bbokser/ponictron/hw/ponictron.kicad_pcb

## KiCad design hw/ponictron.kicad_pcb (2026-02-16)

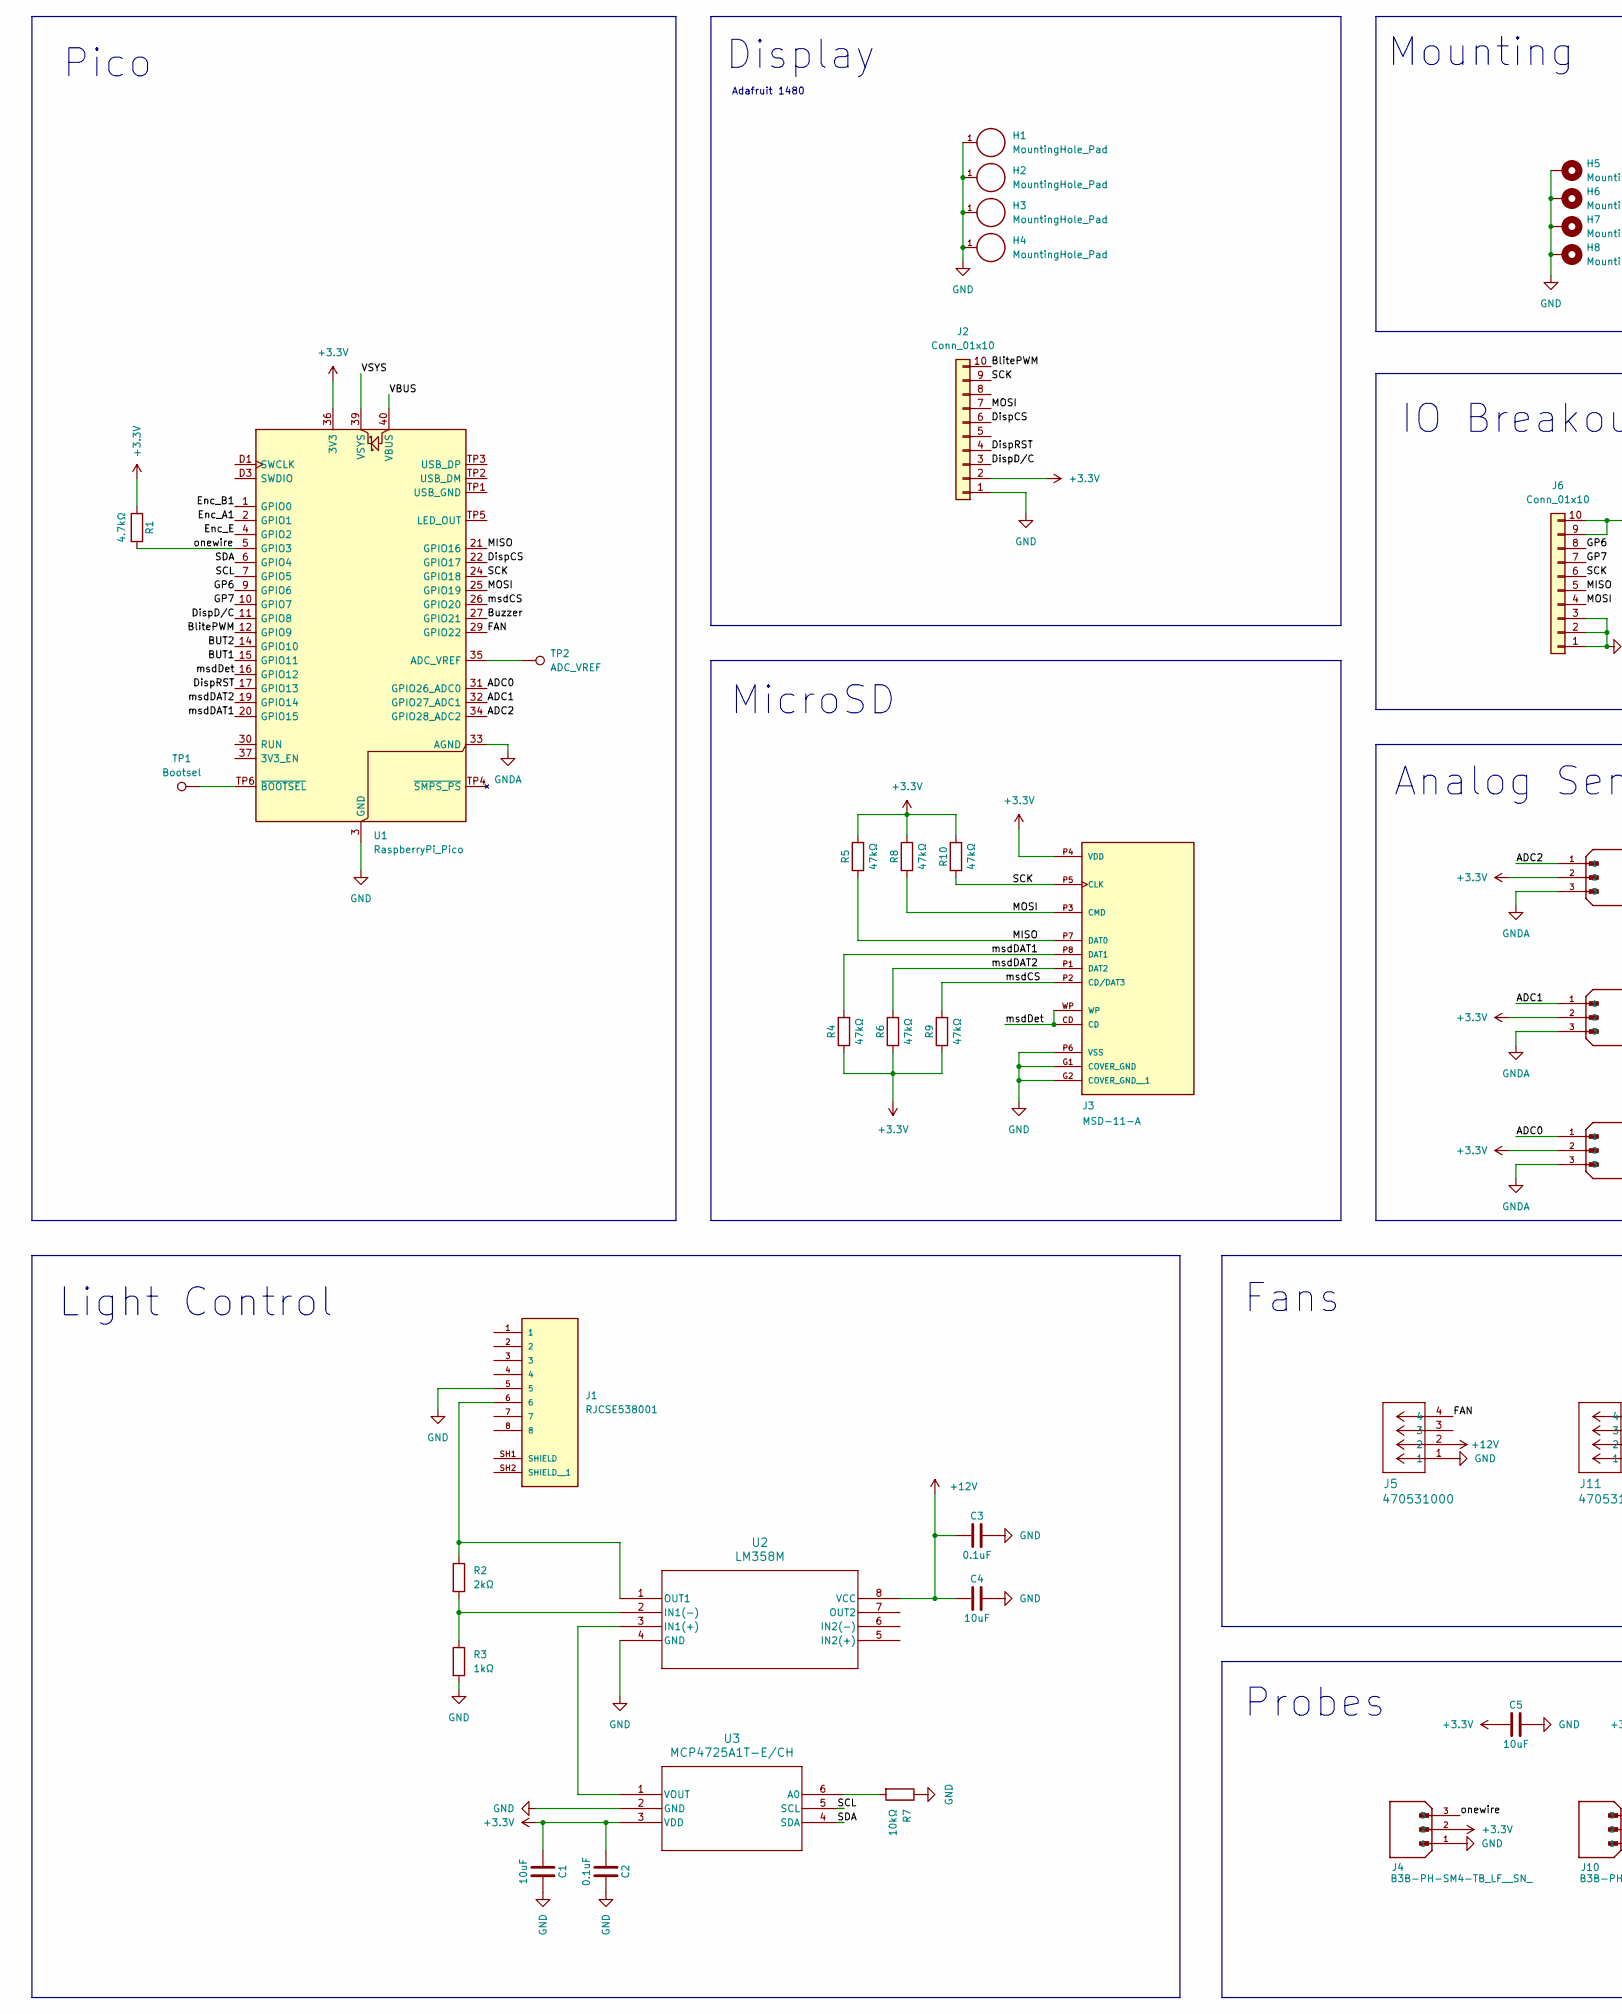
[picture p1: schematic ponictron.kicad_sch, part in row 1, column 1]

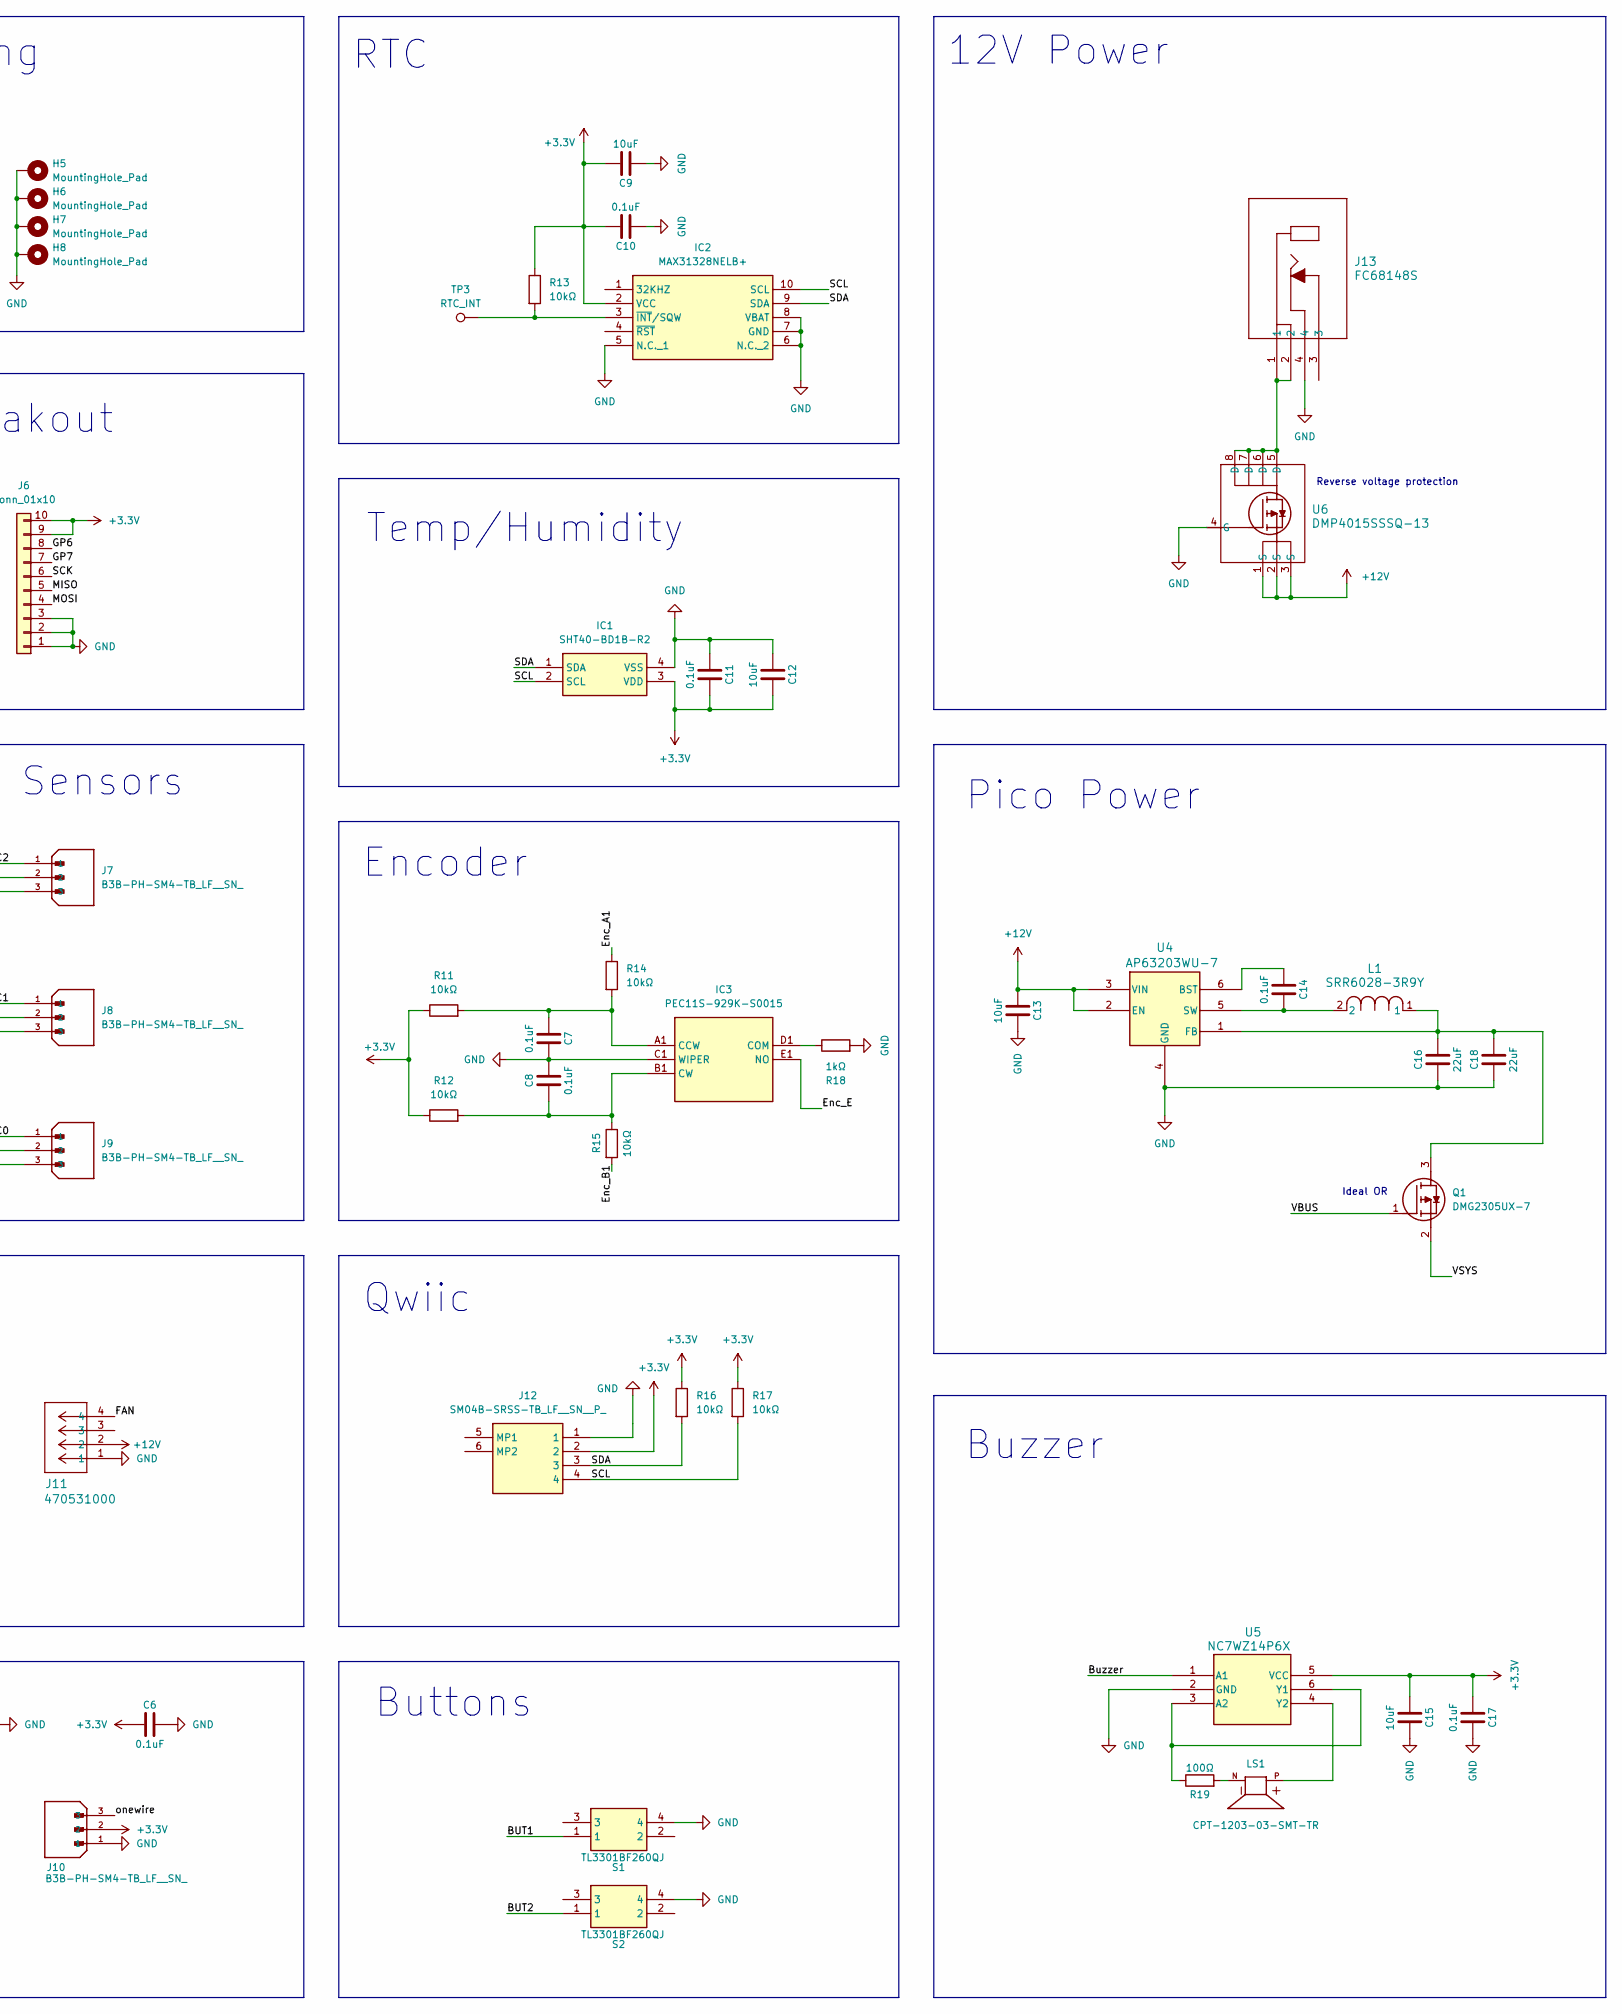
[picture p2: schematic ponictron.kicad_sch, part in row 1, column 2]

Parts:
C1, C4, C5, C9, C12, C13, C15: 10uF; C_0603_1608Metric; LCSC Part # C105524
C2, C3, C6, C7, C8, C10, C11, C14, C17: 0.1uF; C_0603_1608Metric; LCSC Part # C105524
C16, C18: 22uF; C_0603_1608Metric; LCSC Part # C105524
H1, H2, H3, H4: MountingHole_Pad; WE-SMSA_78614015360
H5, H6, H7, H8: MountingHole_Pad; MountingHole_2.7mm_M2.5_DIN965_Pad
IC1: SHT40-BD1B-R2; SHT40BD1BR2; Mouser Part Number 403-SHT40-BD1B-R2
IC2: MAX31328NELB+; MAX31328NELB; Mouser Part Number 700-MAX31328NELB+
IC3: PEC11S-929K-S0015; PEC11S929KS0015; Mouser Part Number 652-PEC11S929K-S0015
J1: RJCSE538001; AMPHENOL_RJCSE538001; PARTREV A
J2, J6: Conn_01x10; PinSocket_1x10_P2.54mm_Vertical
J3: MSD-11-A; CUI_MSD-11-A; PARTREV 1.02
J4, J7, J8, J9, J10: B3B-PH-SM4-TB_LF__SN_; JST_B3B-PH-SM4-TB_LF__SN_; PARTREV N/A
J5, J11: 470531000; CONN_SD-47053-001_H10p00_MOL
J12: SM04B-SRSS-TB_LF__SN__P_; SM04BSRSSTBLFSNP; Mouser Part Number 306-SM04BSRSSTBLFSNP
J13: FC68148S; FC68148S_CLF
L1: SRR6028-3R9Y; IND_BOURNS_SRR6028
LS1: CPT-1203-03-SMT-TR; XDCR_CPT-1203-03-SMT-TR; PARTREV 1.0
Q1: DMG2305UX-7; SOT96P240X115-3N; Mouser Part Number 621-DMG2305UX-7
R1: 4.7kΩ; R_0603_1608Metric_Pad0.98x0.95mm_HandSolder; LCSC Part # C15401
R2: 2kΩ; R_0603_1608Metric_Pad0.98x0.95mm_HandSolder; LCSC Part # C15401
R3: 1kΩ; R_0603_1608Metric_Pad0.98x0.95mm_HandSolder; LCSC Part # C15401
R4, R5, R6, R8, R9, R10: 47kΩ; R_0603_1608Metric_Pad0.98x0.95mm_HandSolder; LCSC Part # C15401
R7, R11, R12, R13, R14, R15, R16, R17: 10kΩ; R_0603_1608Metric_Pad0.98x0.95mm_HandSolder; LCSC Part # C15401
R18: 1kΩ; R_0603_1608Metric_Pad0.98x0.95mm_HandSolder; LCSC Part # C103198
R19: 100Ω; R_0603_1608Metric_Pad0.98x0.95mm_HandSolder; LCSC Part # C15401
S1, S2: TL3301BF260QJ; Mouser Part Number 612-TL3301BF260QJ
TP1: Bootsel; TestPoint_Pad_1.5x1.5mm
TP2: ADC_VREF; TestPoint_Pad_1.5x1.5mm
TP3: RTC_INT; TestPoint_Pad_1.5x1.5mm
U1: RaspberryPi_Pico; RaspberryPi_Pico_Original_SMD
U2: LM358M; 8-SOP_OSI
U3: MCP4725A1T-E/CH; SOT-23-6_MC_MCH
U4: AP63203WU-7; AP63203WU-7_DIO
U5: NC7WZ14P6X; SC70-6_ONS
U6: DMP4015SSSQ-13; SO8_DIO

Connections:
+3.3V: C1.2, C2.2, C5.2, C6.2, C9.1, C10.1, C11.1, C12.1, C15.2, C17.2, IC1.3 (VDD), IC2.2 (VCC), J2.2, J3.P4 (VDD), J4.2, J6.9, J6.10, J7.2, J8.2, J9.2, J10.2, J12.2, R1.1, R4.1, R5.2, R6.1, R8.2, R9.1, R10.2, R11.1, R12.1, R13.1, R16.1, R17.1, U1.36 (3V3), U3.3 (VDD), U5.5 (VCC)
+12V: C3.2, C4.2, C13.2, J5.2, J11.2, U2.8 (VCC), U4.2 (EN), U4.3 (VIN), U6.1 (S), U6.2 (S), U6.3 (S)
/ADC0: J9.1, U1.31 (GPIO26_ADC0)
/ADC1: J8.1, U1.32 (GPIO27_ADC1)
/ADC2: J7.1, U1.34 (GPIO28_ADC2)
/BUT1: S1.1, U1.15 (GPIO11)
/BUT2: S2.1, U1.14 (GPIO10)
/BlitePWM: J2.10, U1.12 (GPIO9)
/Buzzer: U1.27 (GPIO21), U5.1 (A1)
/DispCS: J2.6, U1.22 (GPIO17)
/DispD/C: J2.3, U1.11 (GPIO8)
/DispRST: J2.4, U1.17 (GPIO13)
/Enc_A1: R14.1, U1.2 (GPIO1)
/Enc_B1: R15.2, U1.1 (GPIO0)
/Enc_E: IC3.E1 (NO), U1.4 (GPIO2)
/FAN: J5.4, J11.4, U1.29 (GPIO22)
/GP6: J6.8, U1.9 (GPIO6)
/GP7: J6.7, U1.10 (GPIO7)
/MISO: J3.P7 (DAT0), J6.5, R5.1, U1.21 (GPIO16)
/MOSI: J2.7, J3.P3 (CMD), J6.4, R8.1, U1.25 (GPIO19)
/SCK: J2.9, J3.P5 (CLK), J6.6, R10.1, U1.24 (GPIO18)
/SCL: IC1.2 (SCL), IC2.10 (SCL), J12.4, R17.2, U1.7 (GPIO5), U3.5 (SCL)
/SDA: IC1.1 (SDA), IC2.9 (SDA), J12.3, R16.2, U1.6 (GPIO4), U3.4 (SDA)
/VBUS: Q1.1 (G), U1.40 (VBUS)
/VSYS: Q1.2 (S), U1.39 (VSYS)
/msdCS: J3.P2 (CD/DAT3), R9.2, U1.26 (GPIO20)
/msdDAT1: J3.P8 (DAT1), R4.2, U1.20 (GPIO15)
/msdDAT2: J3.P1 (DAT2), R6.2, U1.19 (GPIO14)
/msdDet: J3.CD, J3.WP, U1.16 (GPIO12)
/onewire: J4.3, J10.3, R1.2, U1.5 (GPIO3)
GND: C1.1, C2.1, C3.1, C4.1, C5.1, C6.1, C7.1, C8.1, C9.2, C10.2, C11.2, C12.2, C13.1, C15.1, C16.2, C17.1, C18.2, H1.1, H2.1, H3.1, H4.1, H5.1, H6.1, H7.1, H8.1, IC1.4 (VSS), IC2.5 (N.C._1), IC2.6 (N.C._2), IC2.7 (GND), IC2.8 (VBAT), IC3.C1 (WIPER), J1.5, J2.1, J3.G1 (COVER_GND), J3.G2 (COVER_GND__1), J3.P6 (VSS), J4.1, J5.1, J6.1, J6.2, J6.3, J10.1, J11.1, J12.1, J13.4, R3.2, R7.1, R18.2, S1.4, S2.4, U1.3 (GND), U1.8 (GND), U1.13 (GND), U1.18 (GND), U1.23 (GND), U1.28 (GND), U1.38 (GND), U1.D2 (GND), U2.4 (GND), U3.2 (GND), U4.4 (GND), U5.2 (GND), U6.4 (G)
GNDA: J7.3, J8.3, J9.3, U1.33 (AGND)
unnamed: IC2.3 (~INT/SQW), R13.2, TP3.1
unnamed: C7.2, IC3.A1 (CCW), R11.2, R14.2
unnamed: IC3.D1 (COM), R18.1
unnamed: C8.2, IC3.B1 (CW), R12.2, R15.1
unnamed: J13.1, J13.2, U6.5 (D), U6.6 (D), U6.7 (D), U6.8 (D)
unnamed: LS1.N, R19.2
unnamed: C16.1, C18.1, L1.1, Q1.3 (D), U4.1 (FB)
unnamed: TP2.1, U1.35 (ADC_VREF)
unnamed: TP1.1, U1.TP6 (~BOOTSEL)
unnamed: U2.3 (IN1(+)), U3.1 (VOUT)
unnamed: R2.2, R3.1, U2.2 (IN1(-))
unnamed: J1.6, R2.1, U2.1 (OUT1)
unnamed: R7.2, U3.6 (A0)
unnamed: C14.2, U4.6 (BST)
unnamed: C14.1, L1.2, U4.5 (SW)
unnamed: R19.1, U5.3 (A2), U5.6 (Y1)
unnamed: LS1.P, U5.4 (Y2)

Notes on the sheet:
Buttons
Ideal OR
IO Breakout
MicroSD
Adafruit 1480
Fans
Mounting
Reverse voltage protection
Analog Sensors
RTC
Display
Buzzer
Encoder
Probes
12V Power
Temp/Humidity
Qwiic
Light Control
Pico
Pico Power

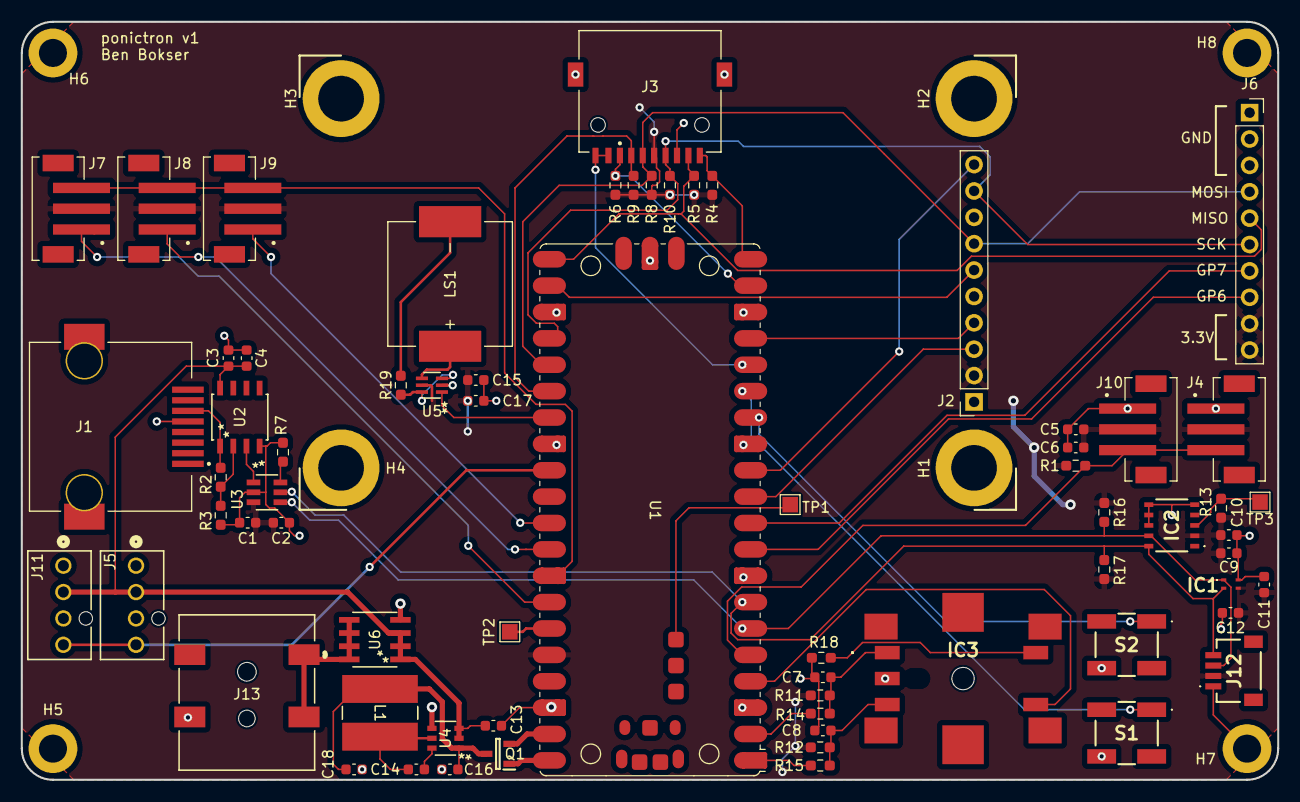
[picture p3: board ponictron.kicad_pcb from above]

Board: 2 copper layers, 121.0 x 73.0 mm, 75 parts (0 on the bottom side), 49 nets.
