bbokser/ponictron/src/dac.py

import adafruit_mcp4725
from busio import I2C


class DAC:
    def __init__(self, i2c: I2C):
        # Initialize MCP4725
        self.mcp4725 = adafruit_mcp4725.MCP4725(i2c)

    def set_value(self, value: float):
        try:
            self.mcp4725.normalized_value = value
        except Exception:
            pass
