bbokser/ponictron/src/led.py

import pwmio


class LED:
    def __init__(self, pin, brightness=1, frequency=5000):
        self.led = pwmio.PWMOut(pin, frequency=frequency, duty_cycle=0)
        self.set_brightness(brightness)

    def save_brightness(self, percent: float):
        assert 0 <= percent <= 1
        self._saved_duty_cycle = int(percent * 65535)

    def set_brightness(self, percent: float):
        self.save_brightness(percent)
        self.on()

    def get_brightness(self) -> float:
        return float(self._saved_duty_cycle) / 65535

    def blink(self, bool: bool) -> None:
        self.led.duty_cycle = bool * self._saved_duty_cycle

    def on(self):
        self.led.duty_cycle = self._saved_duty_cycle

    def off(self):
        self.led.duty_cycle = 0
