bbokser/ponictron/(commit log)

2025-12-11 Initialize KiCAD project
    [aquaponics_ctrl.kicad_pcb, aquaponics_ctrl.kicad_sch]
2025-12-14 Working on power and light control circuits
    [aquaponics_ctrl.kicad_sch, ponictron.kicad_pcb, ponictron.kicad_sch]
2025-12-15 Finish light control and power circuits
    [ponictron.kicad_sch]
2025-12-15 Further progress on schematic
    [ponictron.kicad_sch]
2025-12-24 Add slider switch
    [ponictron.kicad_sch]
2025-12-27 Further updates to schematic
    [ponictron.kicad_sch]
2025-12-31 Add expander
    [ponictron.kicad_sch]
2025-12-31 Remove expander, switch to TFT display, ready for board layout
    [ponictron.kicad_sch]
2026-01-19 Starting board layout
    [ponictron.kicad_pcb, ponictron.kicad_sch]
2026-01-26 Create board layout
    [ponictron.kicad_pcb, ponictron.kicad_sch]
2026-02-15 Making changes to schematic based on feedback
    [ponictron.kicad_pcb, ponictron.kicad_sch]
2026-02-15 Fix trace widths, update 3D models
    [ponictron.kicad_pcb]
2026-02-16 Change display thru-holes to insert mounts
    [ponictron.kicad_pcb, ponictron.kicad_sch]
2026-06-13 Work around encoder issue using i2c encoder, fixing various issues
    [disp.py, encoder.py, fsm.py, main.py, probe.py]
2026-06-21 Fix various bugs, add brightness range
    [disp.py, fsm.py, led.py, light.py, main.py, micro_sd.py, probe.py]
2026-06-27 Add fan speed setting option
2026-07-02 Fix FSM bug, refactor option transitions
    [fsm.py]
2026-08-10 Fan speed fix, 12AM fix, and minor refactors
    [alarms.py, clock.py, dac.py, disp.py, encoder.py, fan.py, fsm.py, light.py]
